sf-ptal78/HYPER-S3-ROCKET/fault-finding/troubleshooting-guide.md

# Fault-Finding & Troubleshooting Guide

## Common Issues
1. Board Drops Connection During High Power Spikes:
   - Check the Texas Instruments BQ25188 power path.
   - Ensure your 1S LiPo battery is charged above 3.2V.
