sf-ptal78/HYPER-S3-ROCKET/my-crowd-supply-project/getting-started/images/Prototype 2 - Changes Happening.jpg

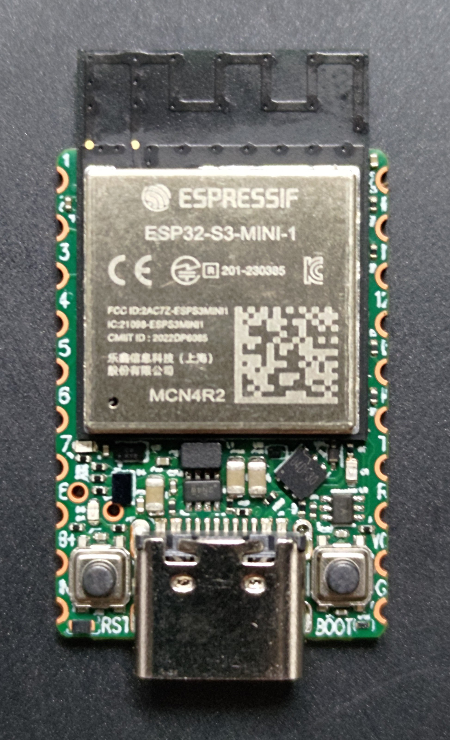
my-crowd-supply-project/getting-started/images/Prototype 2 - Changes Happening.jpg
