sf-ptal78/HYPER-S3-ROCKET/(commit log)

2026-09-25 Add README for HYPER S3 ROCKET Flight Computer
    Added detailed documentation for the HYPER S3 ROCKET flight computer, including hardware advantages, pin allocation, sample code, and licensing information.
2026-09-25 Add sensor initialization and data extraction logic
    This file initializes and configures various sensors including an IMU, magnetometer, and altimeter. It also simulates sensor data extraction and computes deviations from baseline values.
2026-10-02 Create bq25188.py driver module
    Add main driver module file for BQ25188.
2026-10-02 Add hardware_checkout.py for LED and I2C testing
    Added a script to blink LEDs and ping I2C bus.
2026-10-02 Add setup guide for HYPER S3 ROCKET
    Added a comprehensive setup guide for using the HYPER S3 ROCKET with MicroPython and C++ compilers, including installation instructions for Thonny IDE, Arduino IDE, and VS Code.
2026-10-02 Update battery charge requirement to 3.2V
2026-10-02 Add Hello World script for MicroPython
    This script initializes a light on the rocket circuit board and blinks it while printing a hello message.
2026-10-02 Add non-blocking switch routine for MicroPython
    This script implements a non-blocking button toggle routine for a MicroPython environment, allowing users to switch between two LED states based on button presses while avoiding debounce issues.
2026-10-02 Rename Non-Block Switch Routine to Non-Block Switch Routine.py
2026-10-02 Add non-blocking button toggle example for ESP32-S3
    This script implements a non-blocking button toggle functionality for an ESP32-S3, allowing users to switch between two LED states based on button presses.
2026-10-02 Add Arduino Getting Started Guide for Rocket Computer
    Added a comprehensive guide for setting up the Rocket Computer with Arduino, including steps for entering programming mode and configuring board settings.
2026-10-02 Update PSRAM type in Arduino Getting Started Guide
2026-10-02 Rename Button Toggle with Non-Blocking Code.py to Button Toggle with Non-Blocking Code.ino
2026-10-02 Revise Arduino Getting Started Guide for Hyper-S3-Rocket
    Updated the guide to reflect changes in board name and instructions for uploading code.
2026-10-02 Add MicroPython script for LED blinking with PCNT
    Implement a blinking LED using the SiTime clock and ESP32 Pulse Counter.
2026-10-02 Add Arduino sketch for SiTime RTC and LED control
    This Arduino sketch configures a hardware counter using a SiTime RTC and toggles an LED based on pulse counts. It includes setup for GPIO pins, interrupt handling, and serial output for mission time.
2026-10-02 Revise Arduino flashing steps and Serial Monitor rules
    Updated instructions for flashing code and using the Serial Monitor.
2026-10-02 Add button ISR to toggle LEDs without CPU usage
    This sketch implements a hardware interrupt-driven LED toggle using a button press. It utilizes an ISR to change the state of two LEDs based on the button's state.
2026-10-03 Add hardware architecture specifications for HYPER S3 ROCKET
    Added comprehensive hardware architecture and specifications for the HYPER S3 ROCKET, detailing core features, power management, I2C bus architecture, and hardware configurations.
2026-10-03 Enhance hardware architecture specifications and details
    Added detailed descriptions of hardware safety features, power management, and telemetry capabilities. Updated specifications for the Buck-Boost regulator and clarified hardware configurations.
2026-10-03 Update HYPER S3 ROCKET hardware architecture details
    Expanded hardware specifications for the HYPER S3 ROCKET, detailing power management, safety features, and sensor integration.
2026-10-03 Enhance HYPER S3 ROCKET hardware specifications
    Expanded the hardware specifications for the HYPER S3 ROCKET, detailing power management, safety features, and regulatory compliance across various industries.
2026-10-03 Revise HYPER S3 ROCKET hardware specifications
    Updated the HYPER S3 ROCKET specifications to enhance clarity and detail, including hardware features, power management, and safety protocols.
2026-10-03 Update battery safety context in specifications
    Clarified the note regarding battery protection certification and added context for end-users.
2026-10-03 Enhance hardware specifications with telemetry details
    Added core power telemetry and updated solar charging note for voltage limitations.
2026-10-03 Revise hardware architecture specifications for clarity
    Updated terminology and clarified descriptions for battery analytics, protection mechanisms, GPIO functionalities, and other hardware features in the specifications document.
2026-10-03 Clarify optional components in hardware specifications
    Updated the description to clarify the optional nature of the data logging MicroSD and sensor array.
2026-10-03 Revise HYPER S3 ROCKET hardware specifications
    Updated hardware architecture specifications for the HYPER S3 ROCKET, enhancing descriptions of components, power management, and safety features.
2026-10-05 Refine ESP32-S3 hardware architecture details
    Updated hardware architecture specifications for ESP32-S3, enhancing clarity and formatting for features and benefits.
2026-10-06 Enhance HYPER S3 ROCKET hardware specifications
    Updated the description of the HYPER S3 ROCKET to include details about the dual-channel battery management system and its independent hardware protection layers.
2026-10-06 Revise HYPER S3 ROCKET hardware architecture details
    Updated hardware specifications for the HYPER S3 ROCKET, including detailed descriptions of power train, charging, GPIO, and sensor capabilities.
2026-10-06 Revise HYPER S3 ROCKET hardware specifications
    Updated hardware architecture specifications for the HYPER S3 ROCKET, including improved descriptions and added details on power management, safety features, and applications across various industries.
2026-10-06 Refine HYPER S3 ROCKET specifications
    Updated battery diagnostics description and added 'aerospace' to the applications of the HYPER S3 ROCKET.
2026-10-06 Revise README.md for improved clarity and structure
    Updated the README.md to enhance clarity and organization, including sections on hardware advantages, applications by industry, and power management details.
2026-10-06 Revise manufacturing folder description and add exception
    Updated the description of the manufacturing folder and added an exception for the MODULE footprint usage.
2026-10-07 Update hardware specifications for ESP32-S3 module
    Clarified power consumption details for eFuse UVLO and updated EMC testing information.
2026-10-08 Correct form factor dimensions in README
    Updated dimensions of the ESP32-S3 module in the README.
2026-10-08 Update hardware specifications dimensions from 33 mm to 33.5 mm
2026-10-09 Add BQ25188 charging management script with LED indicator
    This script manages the BQ25188 charging IC, controlling an LED indicator based on charging status. It includes I2C communication for register reads/writes and handles power events.
2026-10-10 Add SDMMC 4-bit read example for Arduino
    This sketch initializes an SD card with a specified pin configuration, sets up a status LED, and lists the contents of the SD card directory.
2026-10-10 Add USB mass storage device example for ESP32S3
    This code sets up a USB mass storage device using the ESP32S3. It includes functions for reading and writing data, and initializes the mass storage device in the setup function.
2026-10-10 Add comment for USB-C MicroSD storage example
    Added a comment explaining the storage device functionality using USB-C and Espressif's 4bit SDMMC protocol.
2026-10-10 Enhance SDMMC write and read functions
    Refactor onWrite and onRead functions to handle sector size and aligned copying for improved SD driver compatibility.
2026-10-12 Enhance project description for Live Sensor Plotter
    Updated the project description to include 10 DoF and clarify magnetometer usage.
2026-10-12 Enhance magnetometer handling and user instructions
    Updated the HYPER S3 ROCKET Live Sensor Plotter to enhance functionality and improve user instructions regarding the magnetometer and its modes.
2026-10-13 Update command keys for height and pressure
2026-10-14 Refactor charger control and LED handling
    Refactor charger control code for clarity and functionality improvements. Updated LED handling and I2C communication methods.
2026-10-16 Update sensor descriptions in README.md
2026-10-16 Add non-blocking LED heartbeat to button demo
    Replace the blocking button-release loop with debounced press-state tracking, so button holds no longer pause execution. Add a blue LED heartbeat that continues while the button is held.
2026-10-16 Make LED toggle ISR work without serial
    Use IRAM-safe GPIO writes and microsecond-based debounce in the button ISR, and cap the Serial Monitor wait so the demo also starts on battery.
2026-10-16 Clarify LED names in live plotter
    Update the labels for pins 45 and 46 to match their LED colors and positions.
2026-10-16 Clarify SPL07-006 sensor compatibility
    Document that the SPL07-003 Arduino library supports the board's SPL07-006 sensor, and update serial messages to identify the installed sensor.
2026-10-16 Add non-blocking BQ25188 charging example
    Add a MicroPython example that configures 200 mA charging, monitors charger and VIN status, and drives a charge-status LED with distinct blink patterns.
2026-10-16 Drive RTC blink from PCNT interrupts
    Use the PCNT max event to toggle the LED every 16,384 SiTime clock pulses without resetting the counter in software. Print elapsed seconds from the interrupt callback and keep the main loop idle.
2026-10-16 Add interrupt-driven dual LED toggle example
    Add a MicroPython example that toggles the red and green LEDs with the BOOT button's falling-edge interrupt, including debounce handling and no polling loop.
2026-10-16 Add MicroPython live sensor plotter
    Add an interactive Thonny plotter example for accelerometer, gyroscope, magnetometer, barometer, height, and temperature data. Supports both target IMUs, magnetometer path switching and recovery, sensor zeroing, and LED controls.
2026-10-16 Make switch demo fully non-blocking
    Replace the button wait loop with edge-based debounce handling so a held BOOT button doesn't block the main loop. Add a blue LED heartbeat that continues blinking during button presses.
2026-10-16 Add 4-bit SDMMC file explorer example
    Add a MicroPython example that mounts the microSD card in 4-bit SDMMC mode, lists directory contents with file sizes, and unmounts the card when finished.
2026-10-16 Add MicroPython SPL07 altimeter example
    Add a standalone script to read SPL07 pressure and temperature, calculate altitude, and print measurements at 10 Hz.
2026-10-19 Refactor SDMMC example for USBMSC integration
    Updated SDMMC example to use USBMSC for SD card operations and modified setup for 4-bit pin configuration.
2026-10-19 Refactor Flash Mass Storage Device for SD_MMC usage
    Updated the Flash Mass Storage Device example to use SD_MMC for SD card operations and improved read/write callbacks for high-speed access.
2026-10-31 Fix I2C pin assignments and clarify battery diagnostics
    Updated internal I2C bus pin assignments and improved battery diagnostics description.
2026-10-31 Revise README for ESP32S3 project setup instructions
    Updated notes on PSRAM configuration and project setup for ESP32S3.
2026-10-31 Update button toggling instructions in guide
    Clarified instructions regarding button toggling for uploads.
